Brasletti/PCBs/FuseBit_Doc/USB/bottom_usb.png

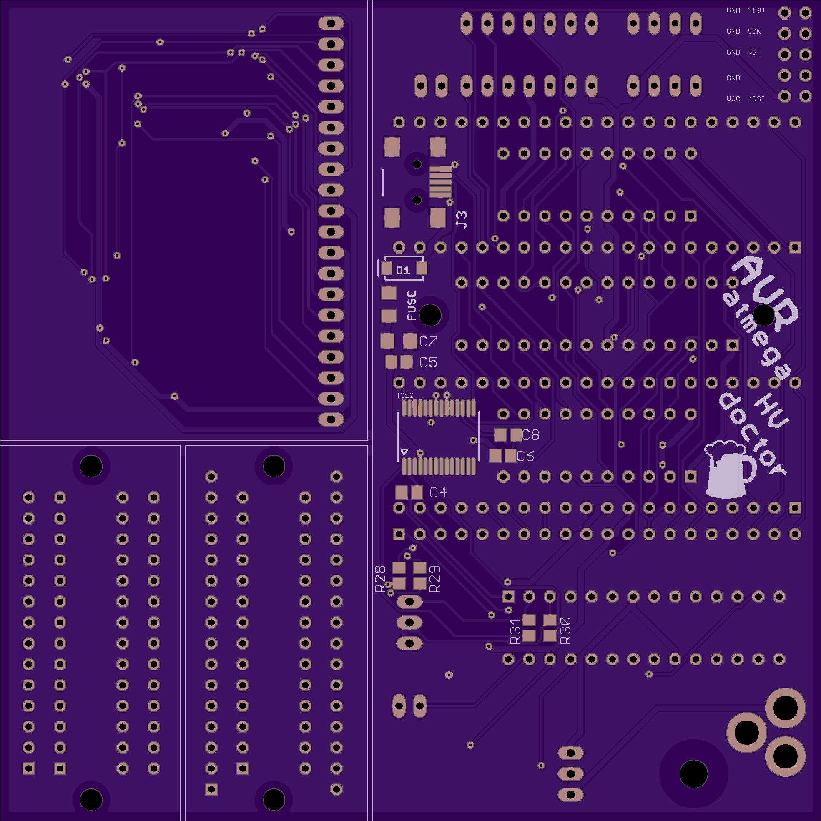
FuseBit_Doc/USB/bottom_usb.png
