Brasletti/PCBs/FuseBit_Doc/USB/top_usb.png

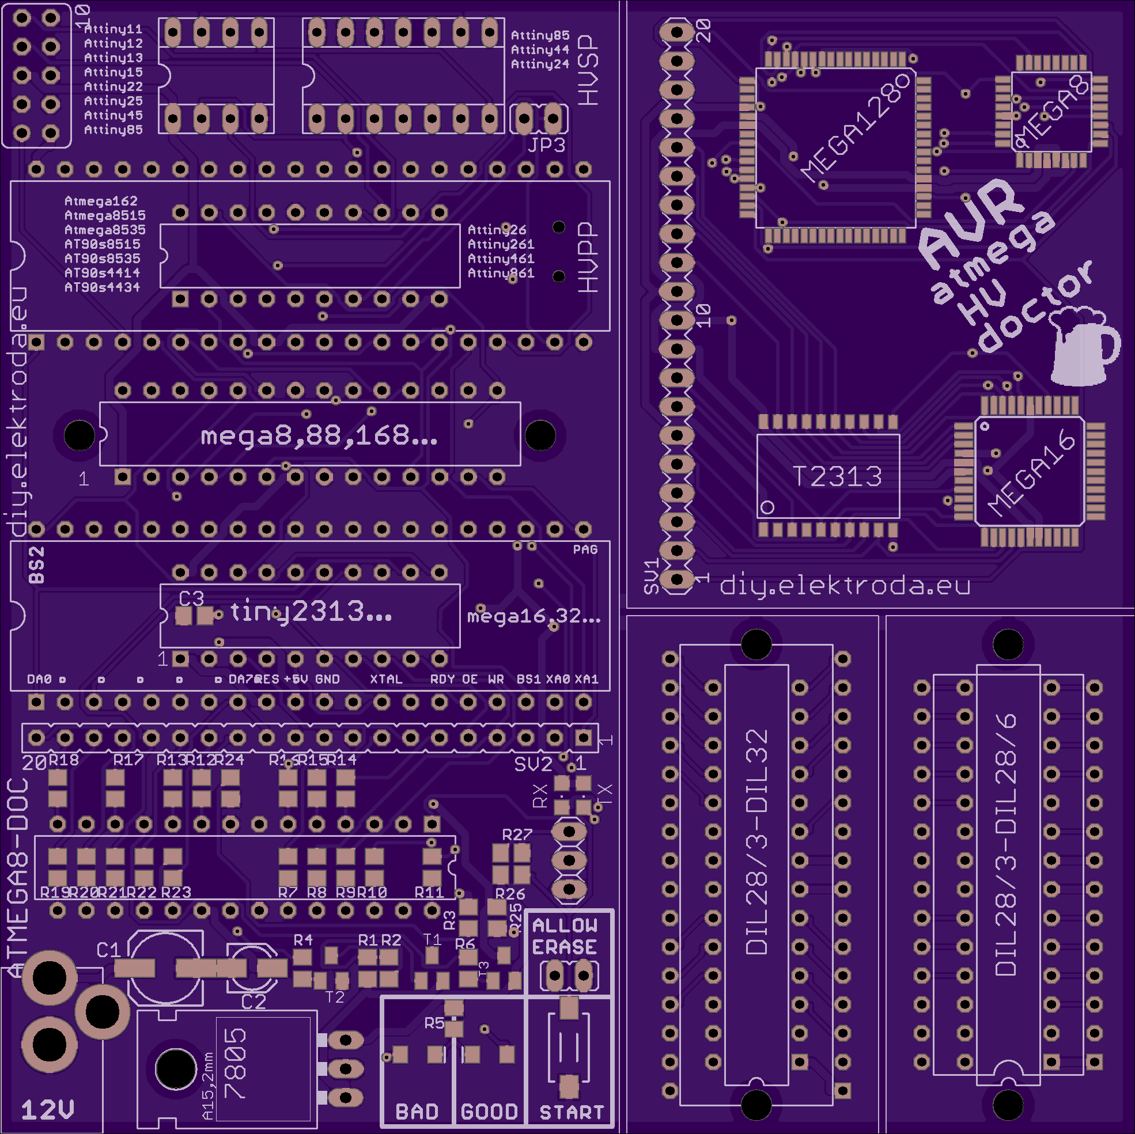
FuseBit_Doc/USB/top_usb.png
