Brasletti/PCBs/FuseBit_Doc/USB/atmega_fusebit_doctor_v2i_USB-Teileliste.xlsx

Qty | Value | Device | Package | Parts | Description |  | Preis/Stück
1 | DIL8 Sockel | DIL8S | SOCKED-DIL08 |  |  |  | 0.12 € | 0.12 €
1 | DIL14 Sockel | DIL14S | SOCKED-DIL14 |  |  |  | 0.16 € | 0.16 €
2 | DIL20 Sockel | DIL20 | SOCKED-DIL20 |  |  |  | 0.26 € | 0.52 €
2 | DIL28 Sockel | DIL28 | SOCKED-DIL28-3 |  |  | Einer zum Sockeln des ATMEGA8-DOC | 0.27 € | 0.54 €
1 | DIL28 Sockel breit | DIL28 | SOCKED-DIL28-6 |  |  | Je nach verwendetem Adapter | 0.31 € | 0.31 €
1 | DIL32 Sockel | DIL32 | SOCKED-DIL32 |  |  | Je nach verwendetem Adapter | 0.29 € | 0.29 €
2 | DIL40 Sockel | DIL40 | SOCKED-DIL40 |  |  |  | 0.13 € | 0.26 €
1 | Pinheader 2,54mm 2x5fach weiblich | FE05-2 | FE05-2 | SV3 | FEMALE HEADER | Weiblich wenn man den USBASP gleich aufstecken möchte. | 0.15 € | 0.15 €
1 | Pinheader 2,54mm 20fach weiblich | FE20-1 | FE20 | SV2 | FEMALE HEADER |  | 0.10 € | 0.10 €
1 | Pinheader 2,54mm 20fach männlich | MA20-1 | MA20-1 | SV1 | PIN HEADER
2 | Pinheader 2,54mm 2fach männlich | MA2-1 | MA2-1
1 | Pinheader 2,54mm 3fach männlich | MA3-1 | MA3-1
2 | Pinheader 2,54mm 14fach rund männlich |  |  |  |  | 2x pro Adapter | 0.28 € | 0.28 €
2 | Jumper |  |  |  |  |  | 0.01 € | 0.02 €
1 | 100uF | CPOL-EU153CLV-0605 | 153CLV-0605 | C1 | POLARIZED CAPACITOR, European symbol |  | 0.04 € | 0.04 €
1 | 10uF | CPOL-EU153CLV-0405 | 153CLV-0405 | C2 | POLARIZED CAPACITOR, European symbol |  | 0.03 € | 0.03 €
1 | 10nF | C-EUC0805 | C0805 | C3 | CAPACITOR, European symbol |  | 0.01 € | 0.01 €
4 | 100nF | C-EUC0805 | C0805 | C4, C5, C6, C8 | CAPACITOR, European symbol |  | 0.01 € | 0.04 €
1 | 4,7uF | C-EUC1206 | C1206 | C7 | CAPACITOR, European symbol |  | 0.01 € | 0.01 €
2 | 10K | R-EU_R0805 | R0805 | R1, R27 | RESISTOR, European symbol |  | 0.01 € | 0.02 €
2 | 4K7 | R-EU_R0805 | R0805 | R4, R6 | RESISTOR, European symbol |  | 0.01 € | 0.02 €
1 | 330R | R-EU_R0805 | R0805 | R5 | RESISTOR, European symbol |  | 0.01 € | 0.01 €
24 | 1K | R-EU_R0805 | R0805 | R2, R7, R8, R9, R10, R11, R12, R13, R14, R15, R16, R17, R18, R19, R20, R21, R22, R23, R24, R26, R28, R29, R30, R31 | RESISTOR, European symbol |  | 0.01 € | 0.24 €
2 | 100R | R-EU_R0805 | R0805 | R3, R25 | RESISTOR, European symbol |  | 0.01 € | 0.02 €
1 | green | LED1206 | LED-1206 | LED2 | LED (Generic) |  | 0.01 € | 0.01 €
1 | red | LED1206 | LED-1206 | LED1 | LED (Generic) |  | 0.01 € | 0.01 €
1 | 2.1MMJACKTHM | 2.1MM JACKTHM | PJ-102A | U$3 | 2.1mm x 5.5mm DC jack |  | 0.04 € | 0.04 €
1 | LM7805 | 78XXL | 78XXL | IC1 | VOLTAGE REGULATOR |  | 0.07 € | 0.07 €
1 | ATMEGA8-DOC | MEGA8-P | DIL28-3_OCT | IC2 | MICROCONTROLLER |  | 2.15 € | 2.15 €
1 | BC847 | BC847 | SOT23 | T2 | NPN TRANSISTOR |  | 0.02 € | 0.02 €
2 | BC857 | BC857 | SOT23-BEC | T1 | PNP Transistror |  | 0.01 € | 0.02 €
1 | SMD button 6x3.5 mm | DTSM-3 | DTSM-3 |  | Diptronics SMD button 6x3.5 mm |  | 0.02 € | 0.02 €
1 | Red | LED0805 | CHIPLED_0805 | RX | Nur für FT232RL Erweiterung |  | 0.01 € | 0.01 €
1 | Green | LED0805 | CHIPLED_0805 | TX | Nur für FT232RL Erweiterung |  | 0.01 € | 0.01 €
1 | FT232RL | FT232RL | SSOP28 | IC12 | Nur für FT232RL Erweiterung |  | 1.45 € | 1.45 €
1 | USB-MINI-B_2 | 0219_14850 | USB-MINI-B_2 | J3 | Nur für FT232RL Erweiterung |  | 0.20 € | 0.20 €
1 | 1A/40V/500mV | DIODE-SCHOTTKY-SS14 | SMA-DIODE | D1 | Nur für FT232RL Erweiterung |  | 0.01 € | 0.01 €
1 | 6V/0.5A | PPTC_HALF-AMP | 1206 FUSE | FUSE | Nur für FT232RL Erweiterung |  | 0.04 € | 0.04 €
1 | Platine |  |  |  |  |  | 2.00 € | 2.00 €
 |  |  |  |  |  |  | SUMME | 9.25 €
