Brasletti/PCBs/FuseBit_Doc/USB/atmega_fusebit_doctor_V2_Custom_7_usb.brd

## EAGLE design FuseBit_Doc/USB/atmega_fusebit_doctor_V2_Custom_7_usb.brd (2018-04-08)

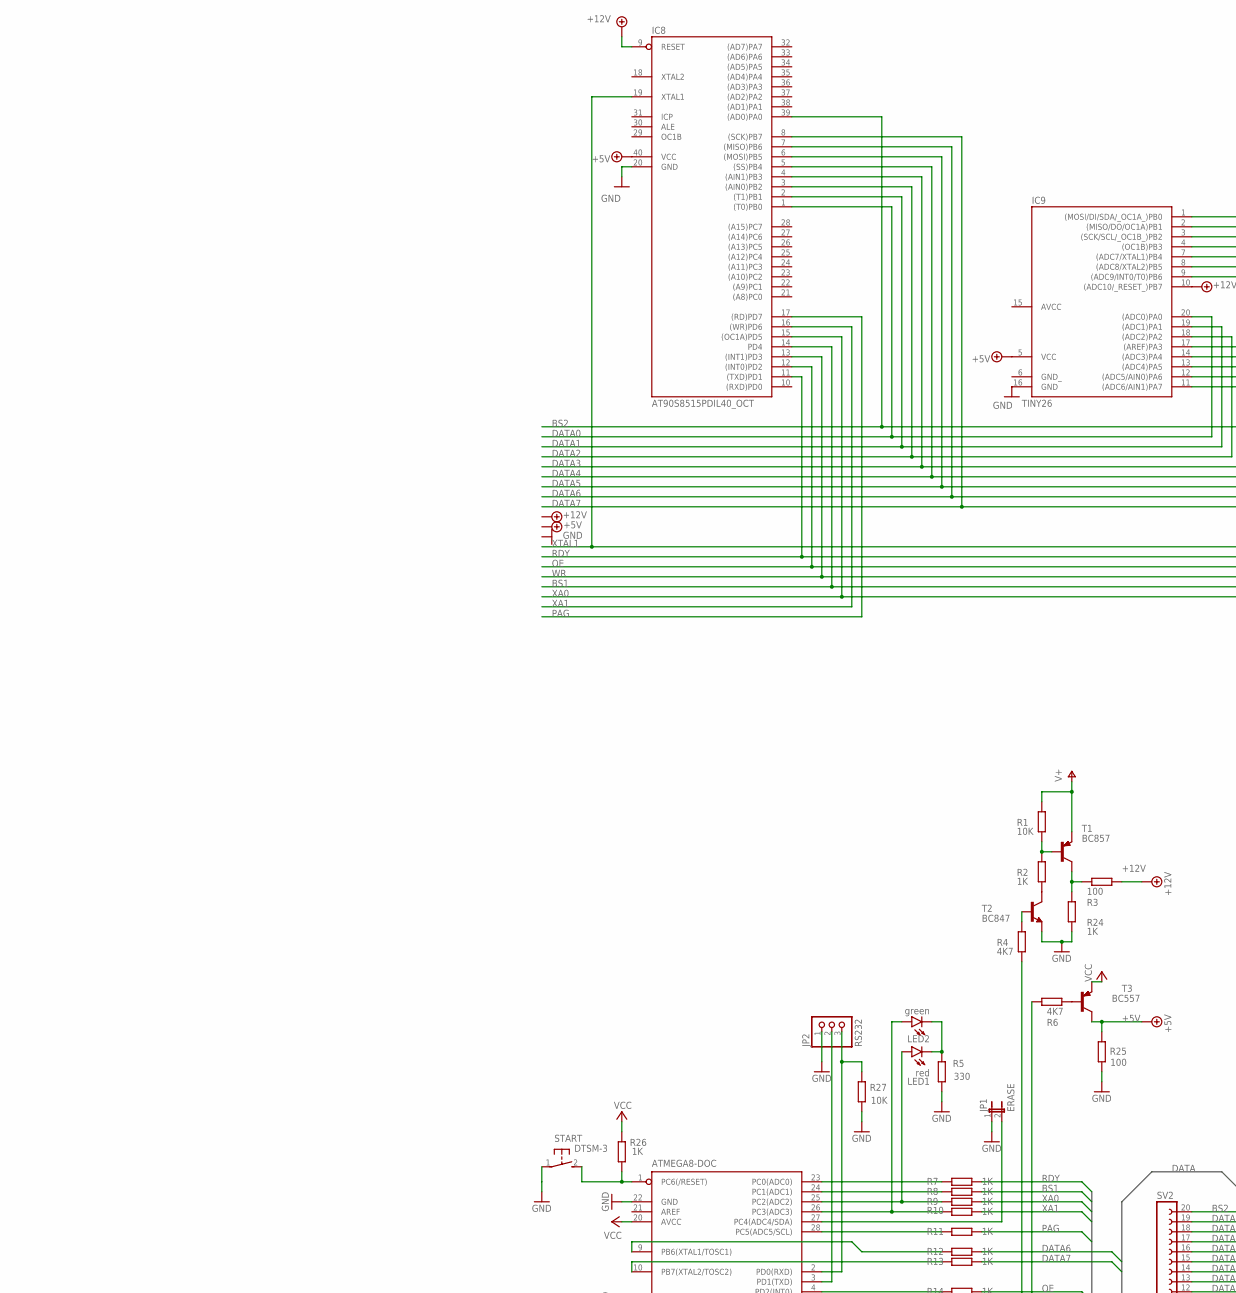
[picture p3: schematic atmega_fusebit_doctor_V2_Custom_7_usb.sch, part in row 1, column 1]

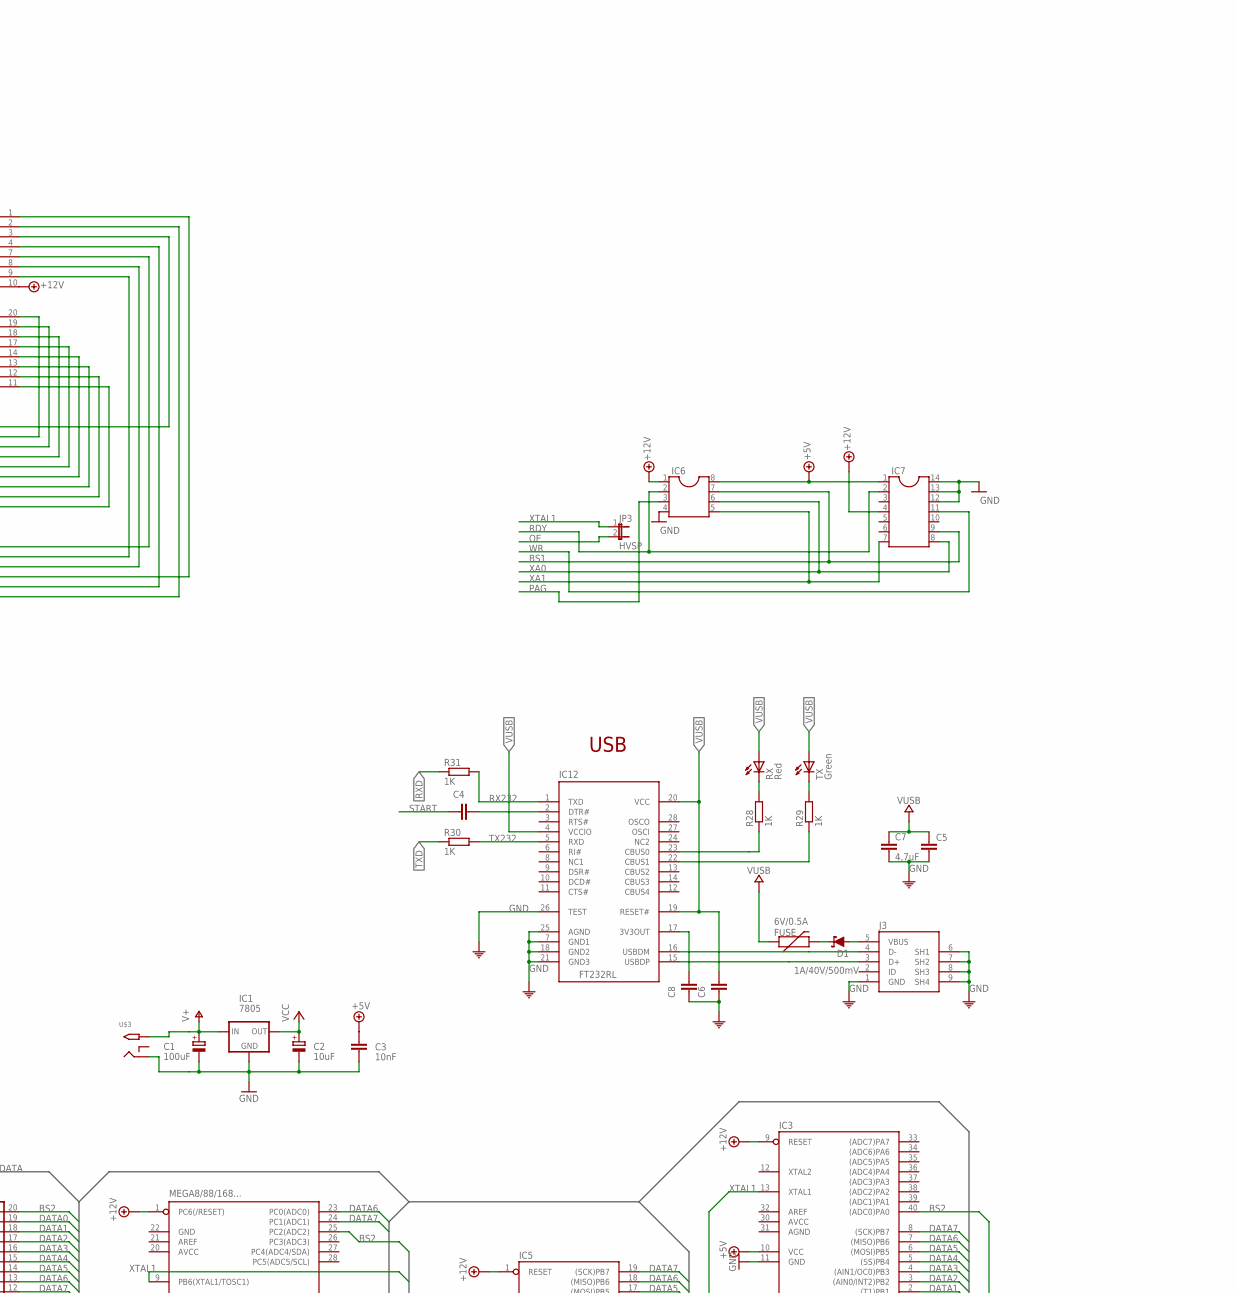
[picture p4: schematic atmega_fusebit_doctor_V2_Custom_7_usb.sch, part in row 1, column 2]

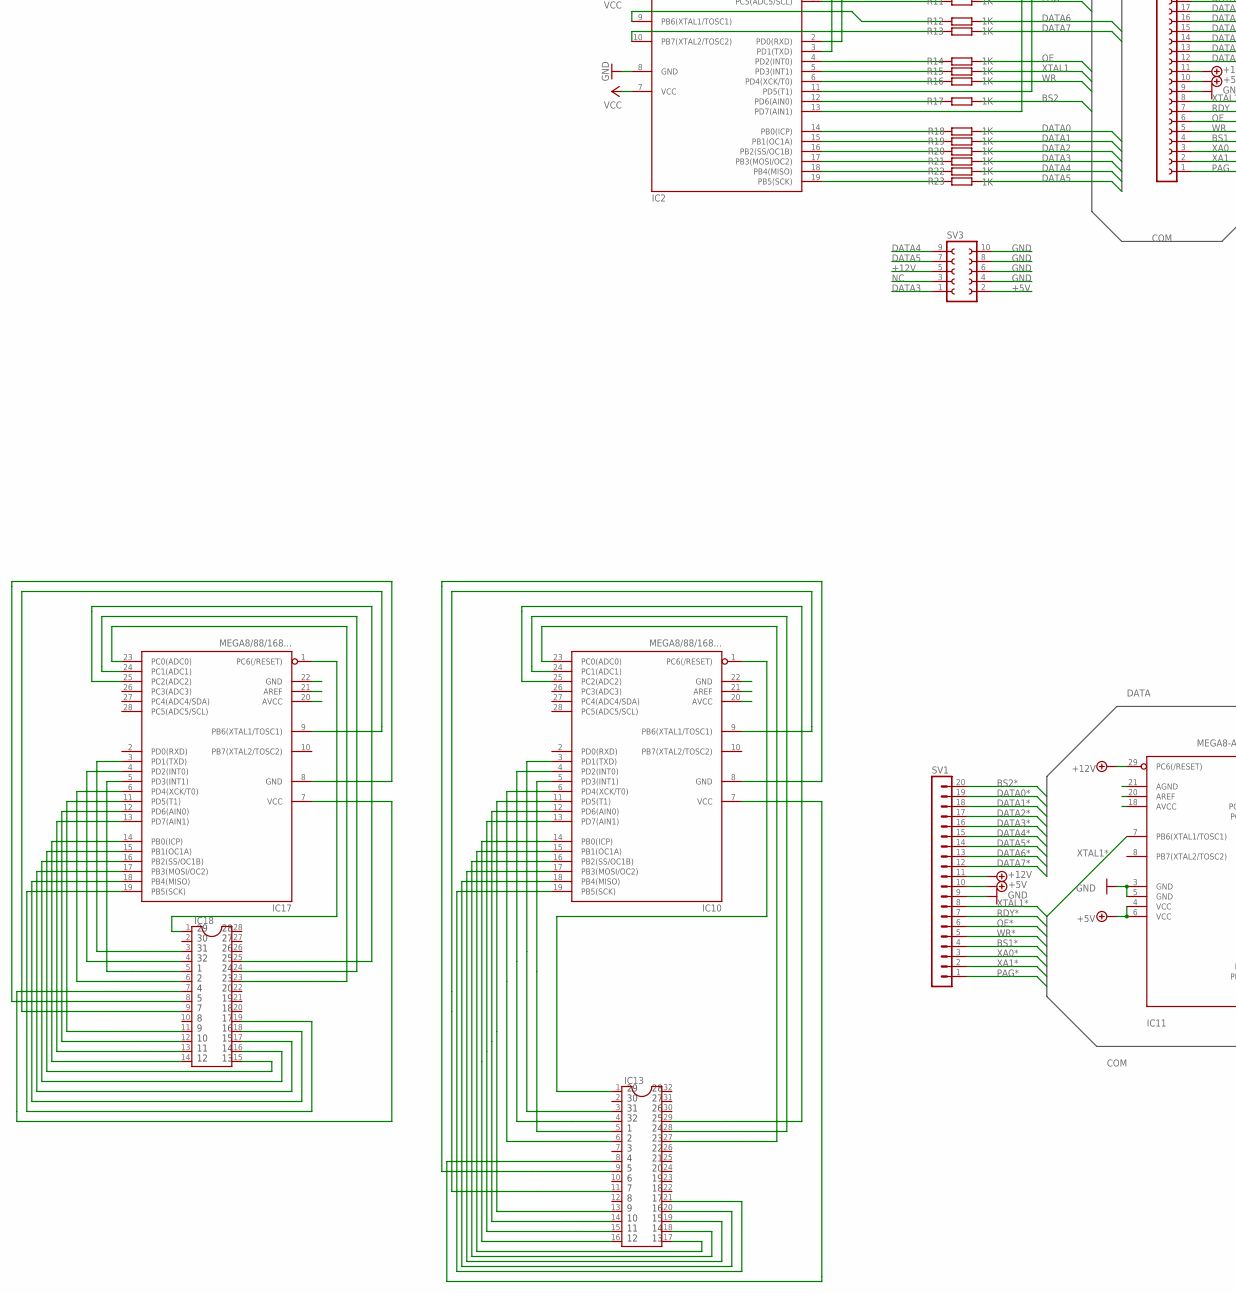
[picture p5: schematic atmega_fusebit_doctor_V2_Custom_7_usb.sch, part in row 2, column 1]

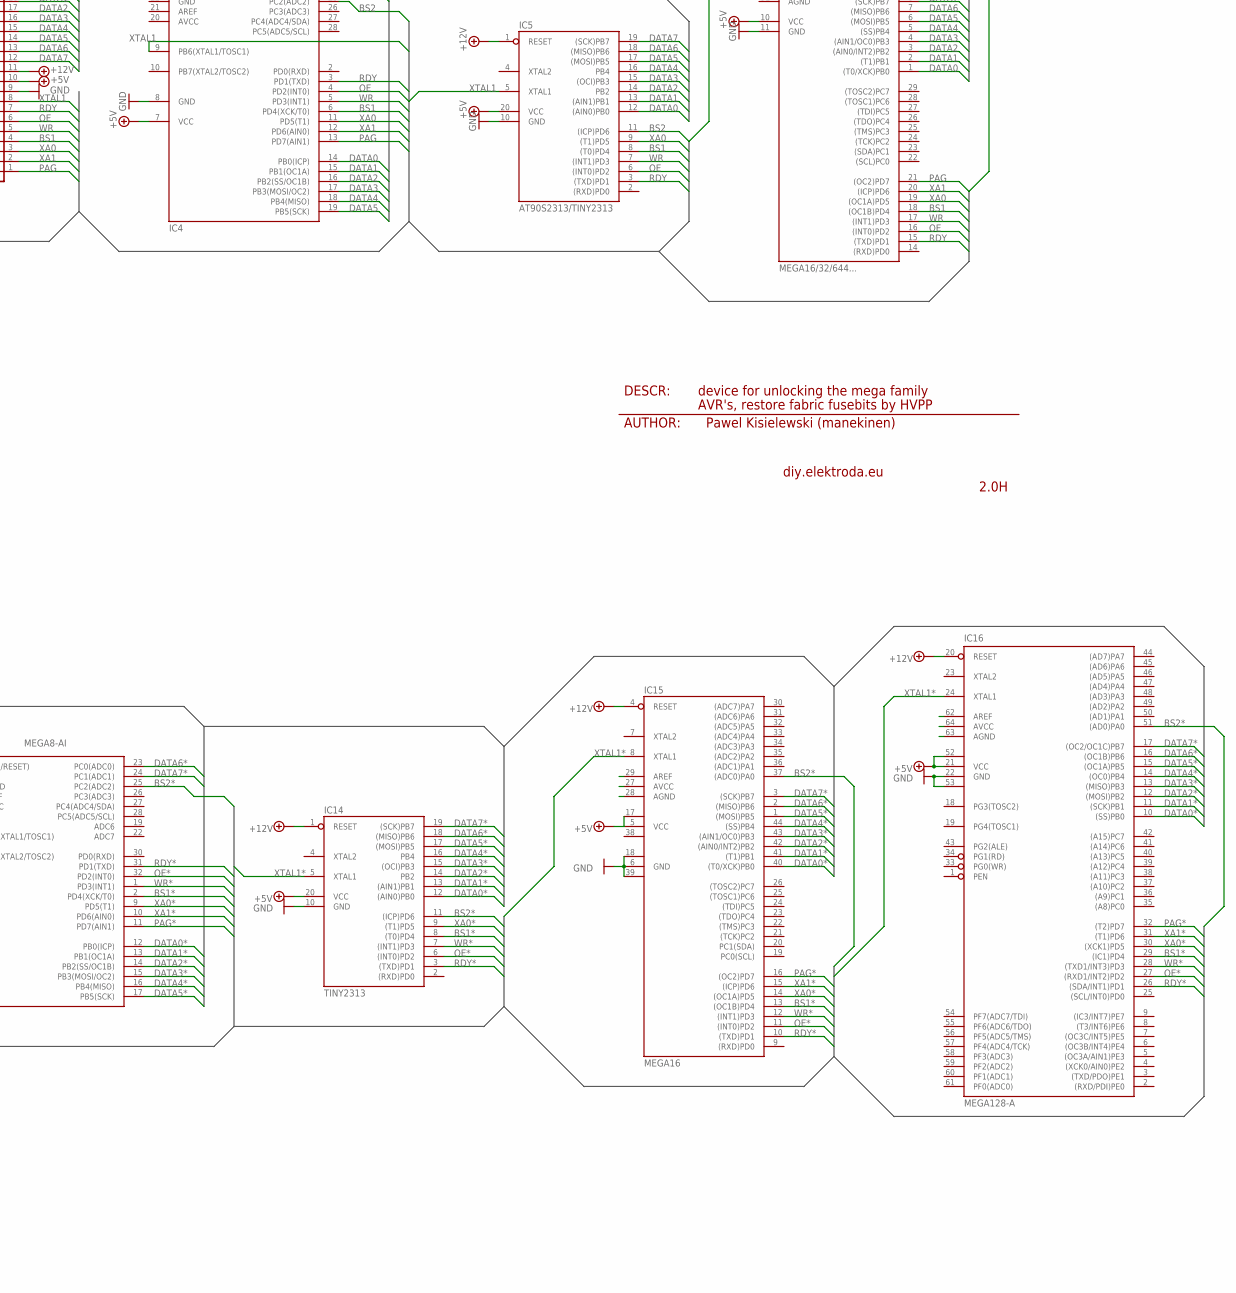
[picture p6: schematic atmega_fusebit_doctor_V2_Custom_7_usb.sch, part in row 2, column 2]

Parts:
C1: 100uF; 153CLV-0605
C2: 10uF; 153CLV-0405
C3: 10nF; C0805
C4, C5, C6, C8: 100nF; C0805
C7: 4,7uF; C1206
D1: 1A/40V/500mV; SMA-DIODE
FUSE: 6V/0.5A; 1206
IC1: 7805; 78XXL
IC2: ATMEGA8-DOC; DIL28-3_OCT
IC3: MEGA16/32/644...; DIL40_OCT
IC4, IC10, IC17: MEGA8/88/168...; DIL28-3_OCT
IC5: AT90S2313/TINY2313; DIL20_OCT
IC6: DIL8S; SOCKED-08
IC7: DIL14S; SOCKED-14
IC8: AT90S8515PDIL40_OCT; DIL40_OCT
IC9: TINY26; DIL20_OCT
IC11: MEGA8-AI; TQFP32-08
IC12: FT232RL; SSOP28
IC13: DIL32
IC14: TINY2313; SO20L
IC15: MEGA16; TQFP44
IC16: MEGA128-A; TQFP64
IC18: DIL28; DIL28-6
J3: 0219_14850; USB-MINI-B_2
JP1: ERASE; JP1
JP2: RS232; 1X03
JP3: HVSP; JP1
LED1: red; LED-1206
LED2: green; LED-1206
R1, R27: 10K; R0805
R2, R7, R8, R9, R10, R11, R12, R13, R14, R15, R16, R17, R18, R19, R20, R21, R22, R23, R24, R26, R28, R29, R30, R31: 1K; R0805
R3, R25: 100; R0805
R4, R6: 4K7; R0805
R5: 330; R0805
RX: Red; CHIPLED_0805
START: DTSM-3
SV1: MA20-1
SV2: FE20-1; FE20
SV3: FE05-2
T1: BC857; SOT23-BEC
T2: BC847; SOT23
T3: BC557; SOT23-BEC
TX: Green; CHIPLED_0805
U$3: 2.1MMJACKTHM; PJ-102A

Connections:
1: IC10.5 (PD3(INT1)), IC13.5
2: IC10.6 (PD4(XCK/T0)), IC13.6
3: IC17.1 (PC6(/RESET)), IC18.1
4: IC10.7 (VCC), IC13.8
5: IC10.8 (GND), IC13.9
7: IC10.9 (PB6(XTAL1/TOSC1)), IC13.11
9: IC10.11 (PD5(T1)), IC13.13
10: IC10.12 (PD6(AIN0)), IC13.14
11: IC10.13 (PD7(AIN1)), IC13.15
12: IC10.14 (PB0(ICP)), IC13.16
13: IC10.15 (PB1(OC1A)), IC13.17
14: IC10.16 (PB2(SS/OC1B)), IC13.18
15: IC10.17 (PB3(MOSI/OC2)), IC13.19
16: IC10.18 (PB4(MISO)), IC13.20
17: IC10.19 (PB5(SCK)), IC13.21
19: IC17.3 (PD1(TXD)), IC18.3
20: IC17.4 (PD2(INT0)), IC18.4
21: IC17.5 (PD3(INT1)), IC18.5
22: IC17.6 (PD4(XCK/T0)), IC18.6
23: IC10.23 (PC0(ADC0)), IC13.27
24: IC10.24 (PC1(ADC1)), IC13.28
25: IC10.25 (PC2(ADC2)), IC13.29
29: IC10.1 (PC6(/RESET)), IC13.1
31: IC10.3 (PD1(TXD)), IC13.3
32: IC10.4 (PD2(INT0)), IC13.4
33: IC17.7 (VCC), IC18.7
34: IC17.8 (GND), IC18.8
35: IC17.9 (PB6(XTAL1/TOSC1)), IC18.9
37: IC17.11 (PD5(T1)), IC18.11
38: IC17.12 (PD6(AIN0)), IC18.12
39: IC17.13 (PD7(AIN1)), IC18.13
40: IC17.14 (PB0(ICP)), IC18.14
41: IC17.15 (PB1(OC1A)), IC18.15
42: IC17.16 (PB2(SS/OC1B)), IC18.16
43: IC17.17 (PB3(MOSI/OC2)), IC18.17
44: IC17.18 (PB4(MISO)), IC18.18
45: IC17.19 (PB5(SCK)), IC18.19
47: IC17.23 (PC0(ADC0)), IC18.23
48: IC17.24 (PC1(ADC1)), IC18.24
49: IC17.25 (PC2(ADC2)), IC18.25
+5V: C3.1, IC3.10 (VCC), IC4.7 (VCC), IC5.20 (VCC), IC6.8, IC7.1, IC8.40 (VCC), IC9.5 (VCC), R25.2, SV2.10, SV3.2, T3.C
+5V*: IC11.4 (VCC), IC11.6 (VCC), IC14.20 (VCC), IC15.5 (VCC), IC15.17 (VCC1), IC16.21 (VCC), IC16.52 (VCC1), SV1.10
+12V: IC3.9 (RESET), IC4.1 (PC6(/RESET)), IC5.1 (RESET), IC6.1, IC7.4, IC8.9 (RESET), IC9.10 ((ADC10/_RESET_)PB7), R3.2, SV2.11, SV3.5
+12V*: IC11.29 (PC6(/RESET)), IC14.1 (RESET), IC15.4 (RESET), IC16.20 (RESET), SV1.11
AGND: IC3.31 (AGND)
AREF: IC3.32 (AREF)
AVCC: IC3.30 (AVCC), IC4.20 (AVCC), IC9.15 (AVCC)
BS1: IC3.18 ((OC1B)PD4), IC4.6 (PD4(XCK/T0)), IC5.8 ((T0)PD4), IC6.7, IC7.9, IC8.14 (PD4), IC9.4 ((OC1B)PB3), R8.2, SV2.4
BS1*: IC11.2 (PD4(XCK/T0)), IC14.8 ((T0)PD4), IC15.13 ((OC1B)PD4), IC16.29 ((IC1)PD4), SV1.4
BS2: IC3.40 ((ADC0)PA0), IC4.25 (PC2(ADC2)), IC5.11 ((ICP)PD6), IC8.39 ((AD0)PA0), IC9.3 ((SCK/SCL/_OC1B_)PB2), R17.2, SV2.20
BS2*: IC11.25 (PC2(ADC2)), IC14.11 ((ICP)PD6), IC15.37 ((ADC0)PA0), IC16.51 ((AD0)PA0), SV1.20
COM: C6.1, C8.1
DATA0: IC3.1 ((T0/XCK)PB0), IC4.14 (PB0(ICP)), IC5.12 ((AIN0)PB0), IC8.1 ((T0)PB0), IC9.20 ((ADC0)PA0), R18.2, SV2.19
DATA0*: IC11.12 (PB0(ICP)), IC14.12 ((AIN0)PB0), IC15.40 ((T0/XCK)PB0), IC16.10 ((SS)PB0), SV1.19
DATA1: IC3.2 ((T1)PB1), IC4.15 (PB1(OC1A)), IC5.13 ((AIN1)PB1), IC8.2 ((T1)PB1), IC9.19 ((ADC1)PA1), R19.2, SV2.18
DATA1*: IC11.13 (PB1(OC1A)), IC14.13 ((AIN1)PB1), IC15.41 ((T1)PB1), IC16.11 ((SCK)PB1), SV1.18
DATA2: IC3.3 ((AIN0/INT2)PB2), IC4.16 (PB2(SS/OC1B)), IC5.14 (PB2), IC8.3 ((AIN0)PB2), IC9.18 ((ADC2)PA2), R20.2, SV2.17
DATA2*: IC11.14 (PB2(SS/OC1B)), IC14.14 (PB2), IC15.42 ((AIN0/INT2)PB2), IC16.12 ((MOSI)PB2), SV1.17
DATA3: IC3.4 ((AIN1/OC0)PB3), IC4.17 (PB3(MOSI/OC2)), IC5.15 ((OCI)PB3), IC8.4 ((AIN1)PB3), IC9.17 ((AREF)PA3), R21.2, SV2.16, SV3.1
DATA3*: IC11.15 (PB3(MOSI/OC2)), IC14.15 ((OCI)PB3), IC15.43 ((AIN1/OC0)PB3), IC16.13 ((MISO)PB3), SV1.16
DATA4: IC3.5 ((SS)PB4), IC4.18 (PB4(MISO)), IC5.16 (PB4), IC8.5 ((SS)PB4), IC9.14 ((ADC3)PA4), R22.2, SV2.15, SV3.9
DATA4*: IC11.16 (PB4(MISO)), IC14.16 (PB4), IC15.44 ((SS)PB4), IC16.14 ((OC0)PB4), SV1.15
DATA5: IC3.6 ((MOSI)PB5), IC4.19 (PB5(SCK)), IC5.17 ((MOSI)PB5), IC8.6 ((MOSI)PB5), IC9.13 ((ADC4)PA5), R23.2, SV2.14, SV3.7
DATA5*: IC11.17 (PB5(SCK)), IC14.17 ((MOSI)PB5), IC15.1 ((MOSI)PB5), IC16.15 ((OC1A)PB5), SV1.14
DATA6: IC3.7 ((MISO)PB6), IC4.23 (PC0(ADC0)), IC5.18 ((MISO)PB6), IC8.7 ((MISO)PB6), IC9.12 ((ADC5/AIN0)PA6), R12.2, SV2.13
DATA6*: IC11.23 (PC0(ADC0)), IC14.18 ((MISO)PB6), IC15.2 ((MISO)PB6), IC16.16 ((OC1B)PB6), SV1.13
DATA7: IC3.8 ((SCK)PB7), IC4.24 (PC1(ADC1)), IC5.19 ((SCK)PB7), IC8.8 ((SCK)PB7), IC9.11 ((ADC6/AIN1)PA7), R13.2, SV2.12
DATA7*: IC11.24 (PC1(ADC1)), IC14.19 ((SCK)PB7), IC15.3 ((SCK)PB7), IC16.17 ((OC2/OC1C)PB7), SV1.12
GND: C1.-, C2.-, C3.2, C5.2, C7.2, IC1.GND, IC2.8 (GND), IC2.22 (GND), IC3.11 (GND), IC4.8 (GND), IC4.22 (GND), IC5.10 (GND), IC6.4, IC7.12, IC7.13, IC7.14, IC8.20 (GND), IC9.16 (GND), IC12.7 (GND1), IC12.18 (GND2), IC12.21 (GND3), IC12.25 (AGND), IC12.26 (TEST), J3.1 (GND), J3.6 (SH1), J3.7 (SH2), J3.8 (SH3), J3.9 (SH4), JP1.1, JP2.1, R5.1, R24.1, R25.1, R27.2, START.1, SV2.9, SV3.4, SV3.6, SV3.8, SV3.10, T2.2 (E), U$3.RING
GND*: IC11.3 (GND), IC11.5 (GND), IC14.10 (GND), IC15.6 (GND), IC15.18 (GND1), IC15.39 (GND2), IC16.22 (GND), IC16.53 (GND1), SV1.9
GND_: IC9.6 (GND_)
unnamed: R6.1, T3.B
unnamed: IC2.14 (PB0(ICP)), R18.1
unnamed: C8.2, IC12.17 (3V3OUT)
unnamed: IC2.28 (PC5(ADC5/SCL)), R11.1
unnamed: IC2.6 (PD4(XCK/T0)), R16.1
unnamed: IC2.4 (PD2(INT0)), R14.1
unnamed: R2.2, T2.3 (C)
unnamed: IC2.9 (PB6(XTAL1/TOSC1)), R12.1
unnamed: IC2.10 (PB7(XTAL2/TOSC2)), R13.1
unnamed: IC2.13 (PD7(AIN1)), R4.2
unnamed: IC2.11 (PD5(T1)), R6.2
unnamed: IC2.15 (PB1(OC1A)), R19.1
unnamed: IC2.16 (PB2(SS/OC1B)), R20.1
unnamed: IC2.5 (PD3(INT1)), R15.1
unnamed: IC2.23 (PC0(ADC0)), R7.1
unnamed: R3.1, R24.2, T1.C
unnamed: IC2.17 (PB3(MOSI/OC2)), R21.1
unnamed: IC2.18 (PB4(MISO)), R22.1
unnamed: IC2.19 (PB5(SCK)), R23.1
unnamed: IC2.12 (PD6(AIN0)), R17.1
unnamed: R4.1, T2.1 (B)
unnamed: IC2.27 (PC4(ADC4/SDA)), JP1.2
unnamed: LED1.C, LED2.C, R5.2
unnamed: R1.2, R2.1, T1.B
unnamed: C4.2, IC12.2 (DTR#)
unnamed: IC2.24 (PC1(ADC1)), R8.1
unnamed: IC12.15 (USBDP), J3.3 (D+)
unnamed: IC12.16 (USBDM), J3.4 (D-)
unnamed: IC12.23 (CBUS0), R28.1
unnamed: IC2.26 (PC3(ADC3)), LED2.A, R10.1
unnamed: IC2.25 (PC2(ADC2)), LED1.A, R9.1
unnamed: IC12.22 (CBUS1), R29.1
unnamed: R28.2, RX.C
unnamed: R29.2, TX.C
NC: SV3.3
OE: IC3.16 ((INT0)PD2), IC4.4 (PD2(INT0)), IC5.6 ((INT0)PD2), IC8.12 ((INT0)PD2), IC9.8 ((ADC8/XTAL2)PB5), JP3.2, R14.2, SV2.6
OE*: IC11.32 (PD2(INT0)), IC14.6 ((INT0)PD2), IC15.11 ((INT0)PD2), IC16.27 ((RXD1/INT2)PD2), SV1.6
PAG: IC3.21 ((OC2)PD7), IC4.13 (PD7(AIN1)), IC6.3, IC8.17 ((RD)PD7), R11.2, SV2.1
PAG*: IC11.11 (PD7(AIN1)), IC15.16 ((OC2)PD7), IC16.32 ((T2)PD7), SV1.1
RDY: IC3.15 ((TXD)PD1), IC4.3 (PD1(TXD)), IC5.3 ((TXD)PD1), IC6.2, IC7.2, IC8.11 ((TXD)PD1), IC9.9 ((ADC9/INT0/T0)PB6), R7.2, SV2.7
RDY*: IC11.31 (PD1(TXD)), IC14.3 ((TXD)PD1), IC15.10 ((TXD)PD1), IC16.26 ((SDA/INT1)PD1), SV1.7
RX232: IC12.1 (TXD), R31.2
RXD: IC2.2 (PD0(RXD)), JP2.3, R27.1, R31.1
START: C4.1, IC2.1 (PC6(/RESET)), R26.1, START.2
TX232: IC12.5 (RXD), R30.2
TXD: IC2.3 (PD1(TXD)), JP2.2, R30.1
V+: C1.+, IC1.IN, R1.1, T1.E, U$3.TIP
VCC: C2.+, IC1.OUT, IC2.7 (VCC), IC2.20 (AVCC), R26.2, T3.E
VCC2: IC15.38 (VCC2)
VUSB: C5.1, C6.2, C7.1, FUSE.1, IC12.4 (VCCIO), IC12.19 (RESET#), IC12.20 (VCC), RX.A, TX.A
VUSB_PREFUSE: D1.C, FUSE.2
VUSB_RAW: D1.A, J3.5 (VBUS)
WR: IC3.17 ((INT1)PD3), IC4.5 (PD3(INT1)), IC5.7 ((INT1)PD3), IC7.11, IC8.13 ((INT1)PD3), IC9.1 ((MOSI/DI/SDA/_OC1A_)PB0), R16.2, SV2.5
WR*: IC11.1 (PD3(INT1)), IC14.7 ((INT1)PD3), IC15.12 ((INT1)PD3), IC16.28 ((TXD1/INT3)PD3), SV1.5
XA0: IC3.19 ((OC1A)PD5), IC4.11 (PD5(T1)), IC5.9 ((T1)PD5), IC6.6, IC7.8, IC8.15 ((OC1A)PD5), IC9.2 ((MISO/DO/OC1A)PB1), R9.2, SV2.3
XA0*: IC11.9 (PD5(T1)), IC14.9 ((T1)PD5), IC15.14 ((OC1A)PD5), IC16.30 ((XCK1)PD5), SV1.3
XA1: IC3.20 ((ICP)PD6), IC4.12 (PD6(AIN0)), IC6.5, IC7.7, IC8.16 ((WR)PD6), R10.2, SV2.2
XA1*: IC11.10 (PD6(AIN0)), IC15.15 ((ICP)PD6), IC16.31 ((T1)PD6), SV1.2
XTAL1: IC3.13 (XTAL1), IC4.9 (PB6(XTAL1/TOSC1)), IC5.5 (XTAL1), IC8.19 (XTAL1), IC9.7 ((ADC7/XTAL1)PB4), JP3.1, R15.2, SV2.8
XTAL1*: IC11.7 (PB6(XTAL1/TOSC1)), IC14.5 (XTAL1), IC15.8 (XTAL1), IC16.24 (XTAL1), SV1.8

Notes on the sheet:
AUTHOR:
DESCR:
device for unlocking the mega family
AVR's, restore fabric fusebits by HVPP
Pawel Kisielewski (manekinen)
2.0H
diy.elektroda.eu
USB

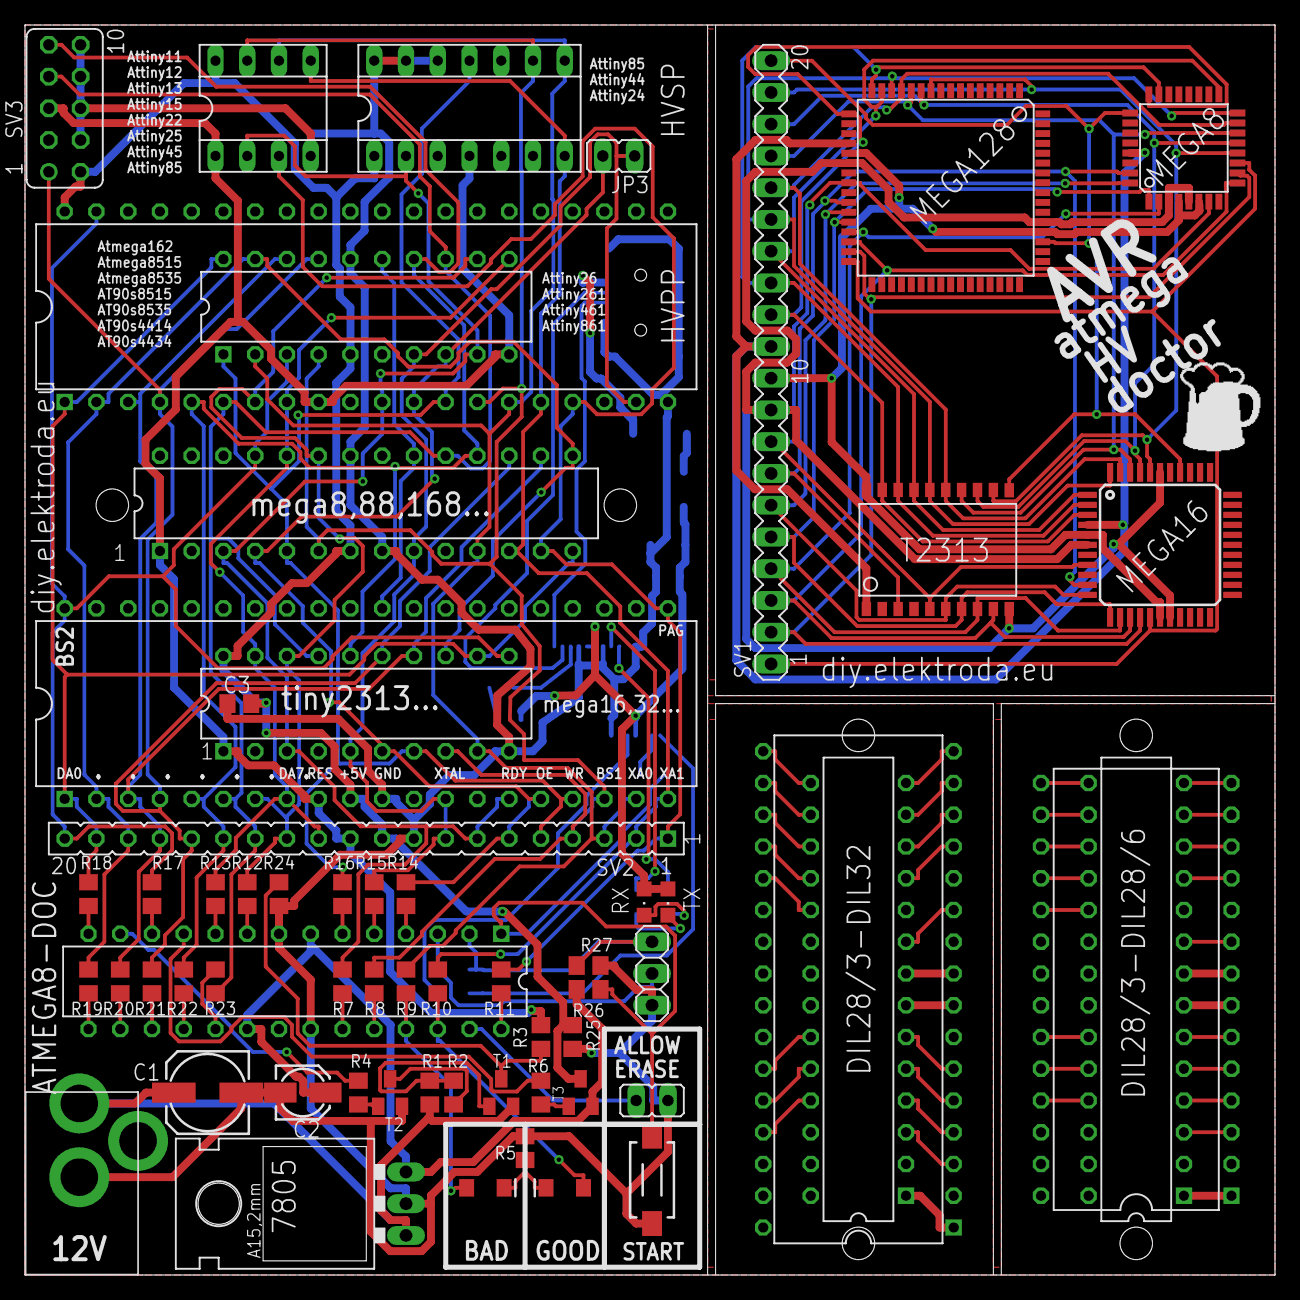
[picture p7: board atmega_fusebit_doctor_V2_Custom_7_usb.brd from above]

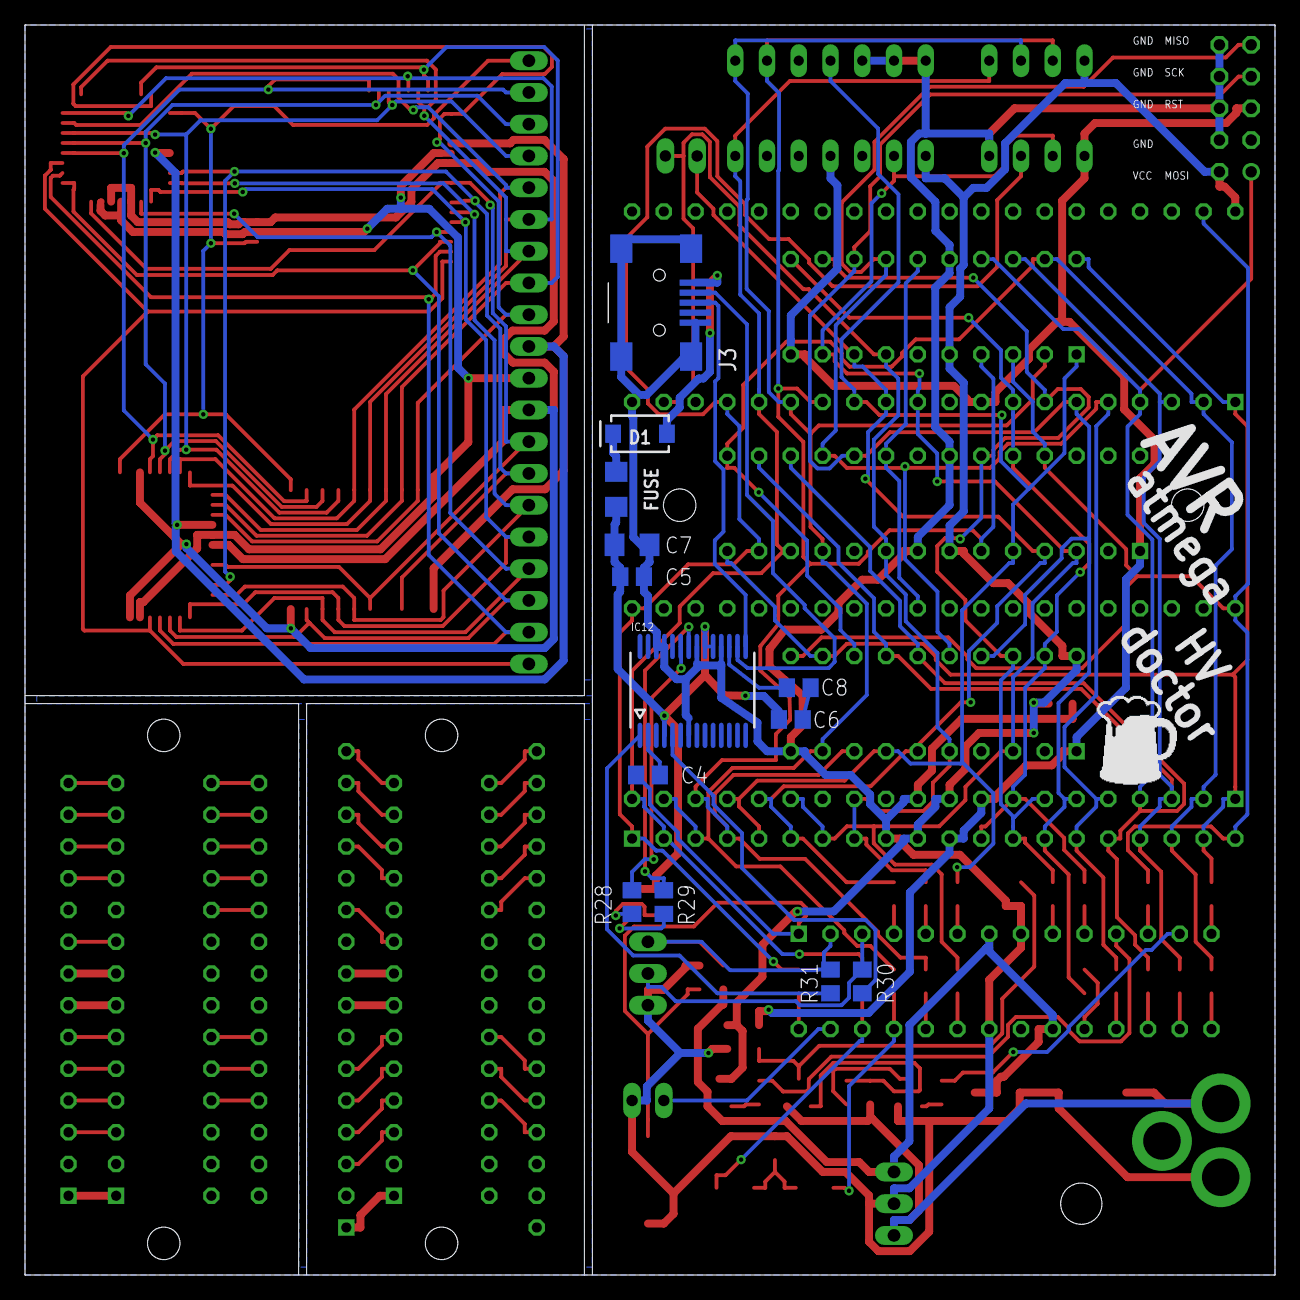
[picture p8: board atmega_fusebit_doctor_V2_Custom_7_usb.brd from below]

Board: 2 copper layers, 100.0 x 100.0 mm, 75 parts (13 on the bottom side), 126 nets.
